pat92fr/SMDMod/ControlBoard/V2/BOM_SmartMotorDriver3A_2021-01-23.csv

ID | Name | Designator | Footprint | Quantity | Manufacturer Part | Manufacturer | Supplier | Supplier Part | JLCPCB SMD | LCSC Assembly
1 | 200 | R4,R8 | R0402 | 2 | 0402WGF2000TCE | UniOhm | LCSC | C25087
2 | 47R | R5 | R0402 | 1 | 0402WGF470JTCE | UniOhm | LCSC | C25118
3 | 100k | R6 | R0402 | 1 | 0402WGF1003TCE | UniOhm | LCSC | C25741
4 | 22k | R7 | R0402 | 1 | 0402WGF2202TCE | UniOhm | LCSC | C25768
5 | 2.2k | R3 | R0402 | 1 | 0402WGF2201TCE | UniOhm | LCSC | C25879
6 | 20k | R9 | R0402 | 1 | 0402WGF2002TCE | UniOhm | LCSC | C25765
7 | LED-0603_R | LED2,LED1 | LED0603_RED | 2 | 19-213/Y2C-CQ2R2L/3T(CY) | EVERLIGHT | LCSC | C72038
8 | STM32G431K8T6 | U1 | LQFP-32_L7.0-W7.0-P0.80-LS9.0-BL | 1 | STM32G431KBT6 | STMicroelectronics | LCSC | C529357
9 | DRV8876PWPR | U3 | HTSSOP-16_L5.0-W4.4-P0.65-LS6.4-BL-EP | 1 | DRV8876PWPR | Texas Instruments | LCSC | C575551 | Yes | Yes
10 | HDR-M-2.54_1x6 | J5 | HDR-M-2.54_1X6 | 1 |  |  | LCSC | C190819
11 | 100nF | C15,C16 | C0603 | 2 | CC0603KRX7R9BB104 | YAGEO | LCSC | C14663 | Yes | Yes
12 | HDR-M-2.54_1x1 | J3,J4,J12 | HDR-M-2.54_1X1 | 3 |  |  | LCSC | C81276
13 | 1.1K | R2 | R0402 | 1 | 0402WGF1101TCE | UniOhm | LCSC | C25860 | Yes | Yes
14 | 470uF | C6 | CAP-SMD_BD10.0-L10.3-W10.3-FD | 1 | RVT1V471M1010 | ROQANG | LCSC | C72519 |  | Yes
15 | TLV70433DBVT | U2 | TSOT-23-5_L2.9-W1.6-P0.95-LS2.8-BR | 1 | TLV70433DBVT | Texas Instruments | LCSC | C94776 | Yes
16 | 10uH | L1 | L0603 | 1 | LBMF1608T100K | TAIYO YUDEN | LCSC | C87216
17 | HDR-M-2.54_1x3 | J2 | HDR-M-2.54_1X3 | 1 |  |  | LCSC | C180248
18 | HDR-M-2.54_1x5 | J1 | HDR-M-2.54_1X5 | 1 |  |  | LCSC | C358687
19 | NC7SP125P5X | U5,U6 | SC-70-5_L2.1-W1.3-P0.65-LS2.1-BR | 2 | NC7SP125P5X | ON Semicon | LCSC | C184652 |  | Yes
20 | TEST-POINT3X5 | TP14,TP1,TP3 | PAD.03X.05 | 3
21 | 1uF | C1,C12 | C0402 | 2 | CL05A105KA5NQNC | SAMSUNG | LCSC | C52923
22 | 4.7uF | C2,C8 | C0402 | 2 | CL05A475MP5NRNC | SAMSUNG | LCSC | C23733
23 | 100nF | C3,C7,C9,C10,C5,C14 | C0402 | 6 | CL05B104KO5NNNC | SAMSUNG | LCSC | C1525
24 | 10nF | C11 | C0402 | 1 | CL05B103KB5NNNC | SAMSUNG | LCSC | C15195
25 | 0.1u | C18 | C0402 | 1 | CL05B104KO5NNNC | SAMSUNG | LCSC | C1525
26 | 22n | C19 | C0402 | 1 | 0402B223K500NT | FH | LCSC | C1532
