pat92fr/SMDMod/ControlBoard/V2/Schematic_SmartMotorDriver3A_2021-01-23.pdf

## Connecteur de puissance et mesure de tension

## Contr leur de puissance moteur et mesure de courant

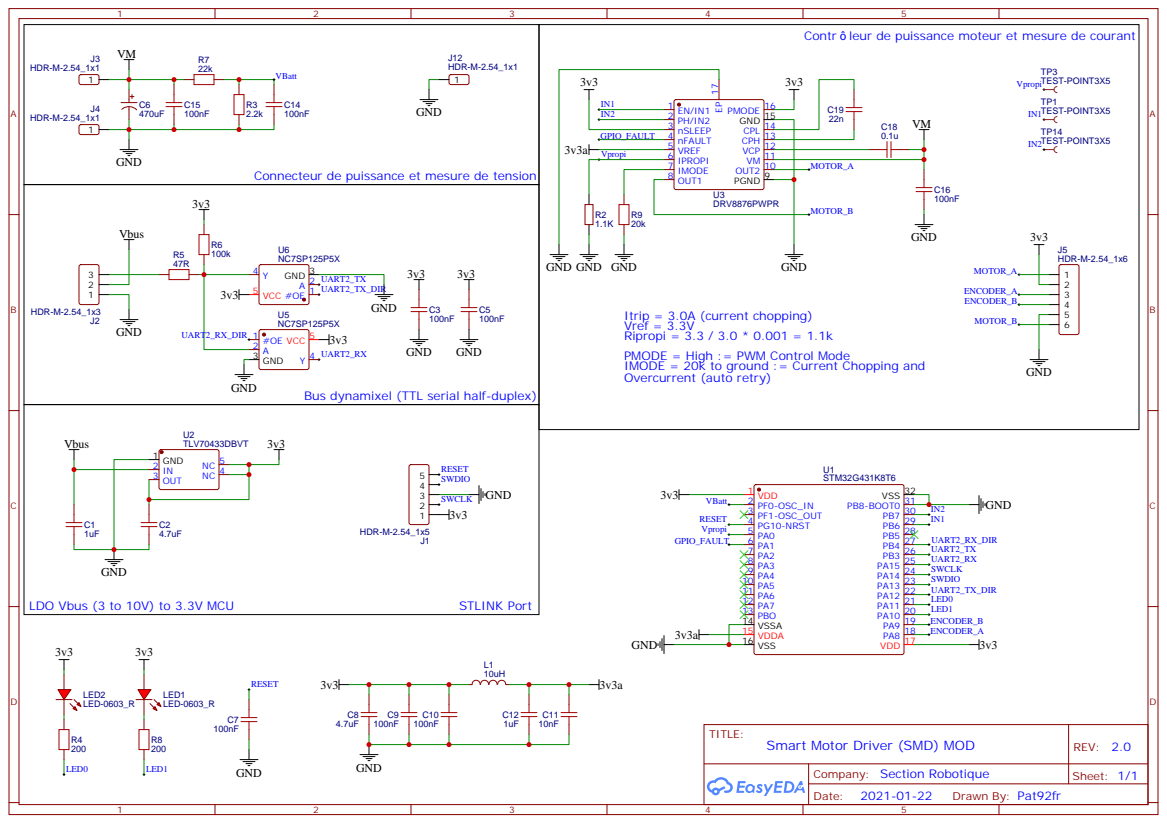
[picture p1: page 1]

OUT2 10 VM 11 VCP 12 CPH 13 CPL 14 GND 15 PMODE 16

Vref = 3.3V
Ripropi = 3.3 / 3.0 * 0.001 = 1.1k
PMODE = High := PWM Control Mode
IMODE = 20k to ground := Current Chopping and
Overcurrent (auto retry)

Bus dynamixel (TTL serial half-duplex)
