pat92fr/SMDMod/ControlBoard/V1/Schematic_SmartMotorDriver3A_2021-01-22.pdf

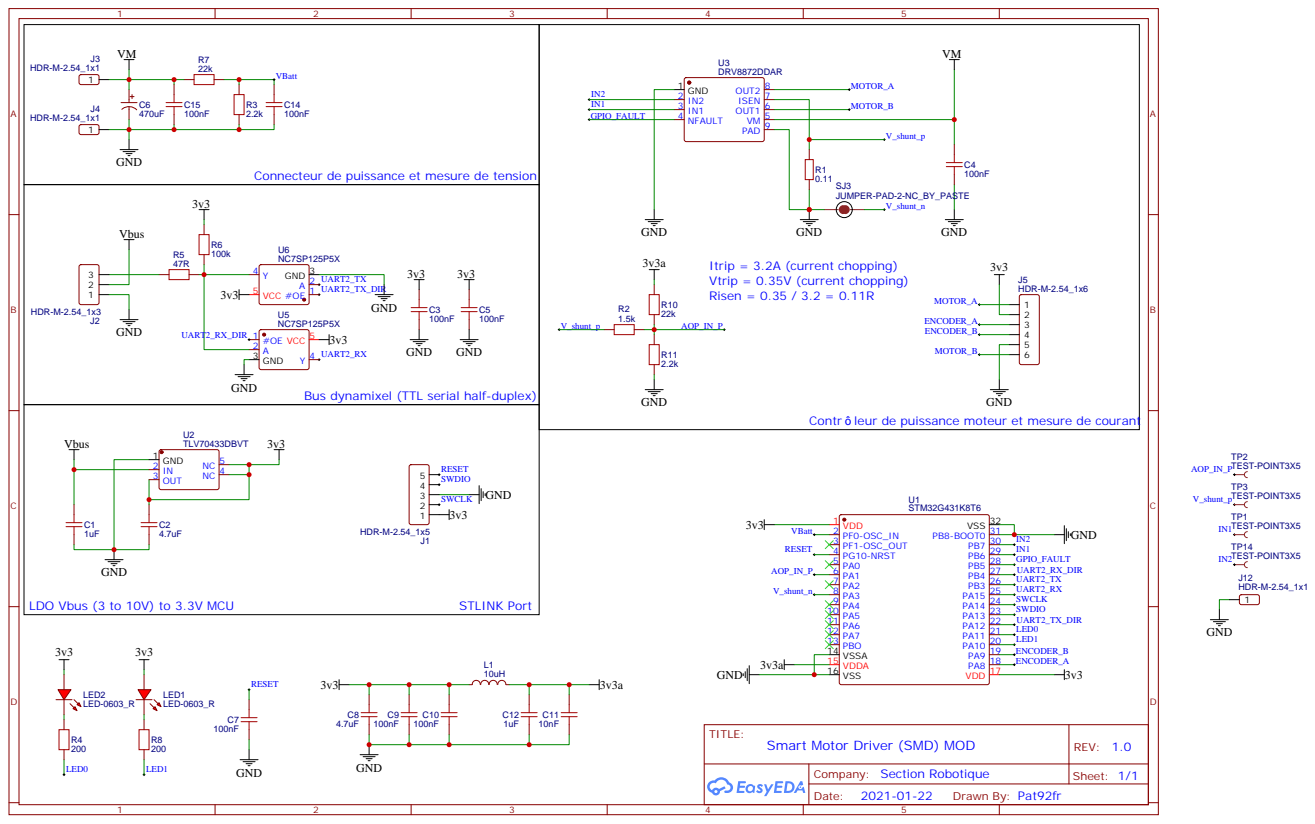
[picture p2: page 1]

Connecteur de puissance et mesure de tension

Bus dynamixel (TTL serial half-duplex)

Contr leur de puissance moteur et mesure de courant
