pat92fr/SMDMod/ControlFirmware/Core/Src/main.c

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
/* Includes ------------------------------------------------------------------*/
#include "main.h"

/* USER CODE BEGIN Includes */
#include "led.h"
#include "serial.h"
#include "eeprom.h"
#include "control_table.h"
#include "control_algo.h"
#include "protocol.h"
/* USER CODE END Includes */

ADC_HandleTypeDef hadc1;
DMA_HandleTypeDef hdma_adc1;

TIM_HandleTypeDef htim1;
TIM_HandleTypeDef htim4;
TIM_HandleTypeDef htim6;

UART_HandleTypeDef huart2;
DMA_HandleTypeDef hdma_usart2_rx;
DMA_HandleTypeDef hdma_usart2_tx;

/* USER CODE BEGIN PV */
HAL_Serial_Handler serial;
/* USER CODE END PV */

void SystemClock_Config(void);
static void MX_GPIO_Init(void);
static void MX_DMA_Init(void);
static void MX_ADC1_Init(void);
static void MX_TIM1_Init(void);
static void MX_TIM4_Init(void);
static void MX_USART2_UART_Init(void);
static void MX_TIM6_Init(void);
/**
  * @brief  The application entry point.
  * @retval int
  */
int main(void)
{
  /* MCU Configuration--------------------------------------------------------*/

  /* Reset of all peripherals, Initializes the Flash interface and the Systick. */
  HAL_Init();

  /* Configure the system clock */
  SystemClock_Config();

  /* Initialize all configured peripherals */
  MX_GPIO_Init();
  MX_DMA_Init();
  MX_ADC1_Init();
  MX_TIM1_Init();
  MX_TIM4_Init();
  MX_USART2_UART_Init();
  MX_TIM6_Init();
  /* USER CODE BEGIN 2 */
	HAL_Led_Init();
	HAL_Led_Blink(LED0,10,150);
	HAL_Led_Blink(LED1,10,150);
	HAL_Serial_Init_Half_Duplex(
		&huart2,
		&serial,
		UART2_TX_DIR_GPIO_Port,
		UART2_TX_DIR_Pin,
		GPIO_PIN_RESET,
		UART2_RX_DIR_GPIO_Port,
		UART2_RX_DIR_Pin,
		GPIO_PIN_RESET
	);
	if(eeprom_empty())
		factory_reset_eeprom_regs();
	load_eeprom_regs();
	reset_ram_regs();
	APP_Control_Init();
  /* USER CODE END 2 */

  /* Infinite loop */
  /* USER CODE BEGIN WHILE */
	uint32_t start_time = HAL_GetTick();
  while (1)
  {
    /* USER CODE END WHILE */

    /* USER CODE BEGIN 3 */
	  // Handle LED
	if(HAL_GetTick()>start_time+2000) // blink first 2 seconds
	{
		if(regs[REG_LED]==0)
		{
			HAL_Led_Reset(LED0);
		}
		else if(regs[REG_LED]==1)
		{
			HAL_Led_Set(LED0);
		}
	}
	HAL_Led_Process();

	// Handle communication
	while(HAL_Serial_Available(&serial))
	{
	  char c = HAL_Serial_GetChar(&serial);
	  packet_handler(c);
	}

	// regulation
	APP_Control_Process();
  }
  /* USER CODE END 3 */
}

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
