pat92fr/SMDMod/ControlFirmware/ControlFirmware.ioc

Mcu.UserName=STM32G431KBTx
PA0.Signal=ADC1_IN1
PA1.GPIO_Label=GPIO_FAULT
PA1.Signal=GPIO_Input
PA10.GPIO_Label=LED1
PA10.Signal=GPIO_Output
PA11.GPIO_Label=LED0
PA11.Signal=GPIO_Output
PA12.GPIO_Label=UART2_TX_DIR
PA12.Signal=GPIO_Output
PA13.Signal=SYS_JTMS-SWDIO
PA14.Signal=SYS_JTCK-SWCLK
PA15.Signal=USART2_RX
PA8.Signal=S_TIM1_CH1
PA9.Signal=S_TIM1_CH2
PB3.Signal=USART2_TX
PB4.GPIO_Label=UART2_RX_DIR
PB4.Signal=GPIO_Output
PB6.Signal=S_TIM4_CH1
PB7.Signal=S_TIM4_CH2
PF0-OSC_IN.Signal=ADC1_IN10
