pat92fr/SMDMod/ControlFirmware/Core/Inc/main.h

#define GPIO_FAULT_Pin GPIO_PIN_1
#define GPIO_FAULT_GPIO_Port GPIOA
#define LED1_Pin GPIO_PIN_10
#define LED1_GPIO_Port GPIOA
#define LED0_Pin GPIO_PIN_11
#define LED0_GPIO_Port GPIOA
#define UART2_TX_DIR_Pin GPIO_PIN_12
#define UART2_TX_DIR_GPIO_Port GPIOA
#define UART2_RX_DIR_Pin GPIO_PIN_4
#define UART2_RX_DIR_GPIO_Port GPIOB
