pat92fr/SMDMod/ControlFirmware/Core/Inc/led.h

/*
 * led.h
 *
 *  Created on: 25 d�c. 2015
 *      Author: Patrick
 */

#ifndef APPLICATION_USER_HAL_LED_H_
#define APPLICATION_USER_HAL_LED_H_


/* Includes ------------------------------------------------------------------*/
#include "stm32g4xx_hal.h"
#include "main.h"

#ifdef __cplusplus
extern "C" {
#endif

/* HAL settings ------------------------------------------------------------------*/

enum LED_ID
{
	LED0 = 0,
	LED1 = 1,
	LED_COUNT
};

static uint16_t const hal_led_id_to_pin[LED_COUNT] = {
		LED0_Pin,
		LED1_Pin
};

static GPIO_TypeDef * const hal_led_id_to_port[LED_COUNT] = {
		LED0_GPIO_Port,
		LED1_GPIO_Port
};

/* HAL Public Data ------------------------------------------------------------------*/

enum LED_STATE
{
    LED_OFF = 0,
    LED_ON = 1
};

/* HAL Functions ------------------------------------------------------------------*/

void HAL_Led_Init(void);
void HAL_Led_Process(void);

void HAL_Led_Set(int id);
void HAL_Led_Reset(int id);
void HAL_Led_Toggle(int id);

int HAL_Led_Get(int id);

void HAL_Led_Blink(int id, int times, int period_ms); // times = 0 ==> non stop blinking

#ifdef __cplusplus
}
#endif

#endif /* APPLICATION_USER_HAL_LED_H_ */
