pat92fr/SMDMod/SMDFireTest/include/sm_protocol.h

// MyServoProtocol is using Serial1 on MEGA
// MyServoProtocol is using Serial2 on M5Stack FIRE (through port C)

// GROVE C port is TX:GPIO17 RX:GPIO16 not usable on fire !
#include <M5Stack.h>
#define GPIO_PIN26 26
#define GPIO_PIN36 36

// REGISTER ADDRESS ///////////////////////////////////////////////////////////

// EEPROM
#define REG_MODEL_NUMBER_L 			0x00
#define REG_MODEL_NUMBER_H 			0x01
#define REG_VERSION		 			0x02
#define REG_ID             			0x03
#define REG_BAUD_RATE      			0x04
#define REG_RETURN_DELAY   			0x05

#define REG_RESERVED_EEPROM_1		0x10 // unused
#define REG_RESERVED_EEPROM_2		0x11 // unused
#define REG_RESERVED_EEPROM_3		0x12 // unused
#define REG_RESERVED_EEPROM_4		0x13 // unused
#define REG_MAX_VELOCITY_DPS_L		0x14
#define REG_MAX_VELOCITY_DPS_H		0x15
#define REG_MAX_ACCELERATION_DPSS_L	0x16
#define REG_MAX_ACCELERATION_DPSS_H	0x17
#define REG_MAX_CURRENT_MA_L		0x18
#define REG_MAX_CURRENT_MA_H		0x19
#define REG_MAX_PWM_100_L			0x1A
#define REG_MAX_PWM_100_H			0x1B
#define REG_TEMPERATURE_LIMIT		0x1C // no sensor
#define REG_LOW_VOLTAGE_LIMIT		0x1D
#define REG_HIGH_VOLTAGE_LIMIT		0x1E

#define REG_MOVING_THRESHOLD_DPS	0x1F
#define REG_STATUS_RETURN_LVL		0x20
#define REG_ALARM_LED				0x21
#define REG_ALARM_SHUTDOWN			0x22

#define REG_CPR_L					0x23
#define REG_CPR_H					0x24
#define REG_REDUCER_L				0x25
#define REG_REDUCER_H				0x26
#define REG_RESERVED_EEPROM_5		0x27 // unused
#define REG_INV_ROTATION_MOTOR		0x28
#define REG_INV_ROTATION_SENSOR 	0x29

#define REG_PID_VELOCITY_KP_L		0x2A
#define REG_PID_VELOCITY_KP_H		0x2B
#define REG_PID_VELOCITY_KI_L		0x2C
#define REG_PID_VELOCITY_KI_H		0x2D
#define REG_PID_VELOCITY_KD_L		0x2E
#define REG_PID_VELOCITY_KD_H		0x2F
#define REG_PID_VELOCITY_KFF_L		0x30
#define REG_PID_VELOCITY_KFF_H		0x31
#define REG_PID_ACCELERATION_KFF_L	0x32
#define REG_PID_ACCELERATION_KFF_H	0x33
#define REG_PID_CURRENT_KP_L		0x34
#define REG_PID_CURRENT_KP_H		0x35
#define REG_PID_CURRENT_KI_L		0x36
#define REG_PID_CURRENT_KI_H		0x37
#define REG_PID_CURRENT_KFF_L		0x38
#define REG_PID_CURRENT_KFF_H		0x39

#define REG_CAL_CURRENT_SENSE_A_L	0x3A
#define REG_CAL_CURRENT_SENSE_A_H	0x3B
#define REG_CAL_VOLTAGE_SENSE_L		0x3C
#define REG_CAL_VOLTAGE_SENSE_H		0x3D

// RAM
#define REG_TORQUE_ENABLE  					0x40
#define REG_LED			  					0x41
#define REG_CONTROL_MODE					0x42
#define REG_GOAL_ACCELERATION_DPSS_L		0x43
#define REG_GOAL_ACCELERATION_DPSS_H		0x44
#define REG_GOAL_VELOCITY_DPS_L				0x45
#define REG_GOAL_VELOCITY_DPS_H				0x46
#define REG_GOAL_CURRENT_MA_L				0x47
#define REG_GOAL_CURRENT_MA_H				0x48
#define REG_GOAL_PWM_100_L					0x49
#define REG_GOAL_PWM_100_H					0x4A
#define REG_RESERVED_RAM_1					0x4B // unused
#define REG_RESERVED_RAM_2					0x4C // unused
#define REG_PRESENT_ACCELERATION_DPSS_L		0x4D
#define REG_PRESENT_ACCELERATION_DPSS_H		0x4E
#define REG_PRESENT_VELOCITY_DPS_L			0x4F
#define REG_PRESENT_VELOCITY_DPS_H			0x50
#define REG_PRESENT_CURRENT_MA_L			0x51
#define REG_PRESENT_CURRENT_MA_H			0x52
#define REG_PRESENT_VOLTAGE					0x53
#define REG_PRESENT_TEMPERATURE 			0x54 // no sensor
#define REG_MOVING			 				0x55
// DEBUG RAM
#define REG_SETPOINT_ACCELERATION_DPSS_L	0x56
#define REG_SETPOINT_ACCELERATION_DPSS_H	0x57
#define REG_SETPOINT_VELOCITY_DPS_L			0x58
#define REG_SETPOINT_VELOCITY_DPS_H			0x59
#define REG_SETPOINT_CURRENT_MA_L			0x5A
#define REG_SETPOINT_CURRENT_MA_H			0x5B
#define REG_SETPOINT_PWM_100_L				0x5C
#define REG_SETPOINT_PWM_100_H				0x5D
#define REG_MOTOR_CURRENT_INPUT_ADC_L 		0x5E
#define REG_MOTOR_CURRENT_INPUT_ADC_H		0x5F
#define REG_DEBUG_RAM_RESERVED_1   			0x60 // unused
#define REG_DEBUG_RAM_RESERVED_2 			0x61 // unused
#define REG_ENCODER_ABSOLUTE_L				0x62
#define REG_ENCODER_ABSOLUTE_H				0x63
#define REG_VOLTAGE_INPUT_ADC_L				0x64
#define REG_VOLTAGE_INPUT_ADC_H				0x65
// SW & HW ERROR
#define REG_PROTOCOL_CRC_FAIL 				0x80
#define REG_HARDWARE_ERROR_STATUS 			0x81
// End
#define REG_MAX             				0x82

// REGISTER CONTROL MODE VALUES //////////////////////////////////////////////////////

#define REG_CONTROL_MODE_OFF 0
#define REG_CONTROL_MODE_ACCELERATION_PROFIL_VELOCITY_TORQUE 1
#define REG_CONTROL_MODE_VELOCITY_TORQUE 2
#define REG_CONTROL_MODE_CURRENT 3
#define REG_CONTROL_MODE_PWM 4


// Buffers
#define TX_BUFFER_SIZE 256
#define RX_BUFFER_SIZE 256

// Packet field position
#define PKT_HEADER0             0
#define PKT_HEADER1             1
#define PKT_HEADER2             2
#define PKT_RESERVED            3
#define PKT_ID                  4
#define PKT_LENGTH_L            5
#define PKT_LENGTH_H            6
#define PKT_INSTRUCTION         7
#define PKT_ERROR               8
#define PKT_PARAMETER0          8
#define PKT_PARAMETER1          9
#define PKT_PARAMETER2          10
#define PKT_PARAMETER3          11
#define PKT_PARAMETER4          12

#define INSTR_PING            0x01
#define INSTR_READ            0x02
#define INSTR_WRITE           0x03
#define INSTR_FACTORY_RESET   0x06
#define INSTR_REBOOT          0x08
#define INSTR_STATUS          0x55
#define INSTR_SYNC_READ       0x82
#define INSTR_SYNC_WRITE      0x83

#define ERROR_NONE                0x00
#define ERROR_RESULT_FAIL         0x01
#define ERROR_INSTRUCTION_ERROR   0x02
#define ERROR_CRC_ERROR           0x03
#define ERROR_DATA_RANGE_ERROR    0x04
#define ERROR_DATA_LENGTH_ERROR   0x05
#define ERROR_DATA_LIMIT_ERROR    0x06
#define ERROR_ACCESS_ERROR        0x07

// binary tool macro
#define LOW_BYTE(x)     ((unsigned char)((x)&0xFF))
#define HIGH_BYTE(x)    ((unsigned char)(((x)>>8)&0xFF))
#define MAKE_SHORT(l,h) (((uint16_t)((h)&0xFF)<<8) | (uint16_t)((l)&0xFF))
#define SIGN(x)         (((x)&0x8000)?((x)-0x10000):(x))


class sm_protocol
{
  
public:  
  sm_protocol(uint32_t baud):
    verbose(0),
    rx_packet_position(0),
    rx_packet_payload_length(0),
    tx_packet_length(0),
    rx_packet_id(0),
    rx_packet_instruction(0),
    rx_packet_error(0),
    rx_packet_crc(0),
    rx_timeout_us(10000),
    MySerial(2)
    {
        // MEGA 16MHz:
        //  baud = 115200 OK 1.4ms reply
        //  baud = 250000 OK 0.7ms reply
        //  baud = 500000 OK 440us reply
        //  baud = 1000000 OK 430us reply
        // M5Stack:
        //  baud = 500000 OK
        //  baud = 1000000 OK
        MySerial.begin(baud, SERIAL_8N1,GPIO_PIN36,GPIO_PIN26);
    } // 10ms
  
    int verbose;

    struct sync_byte_data
  {
    uint8_t id;
    uint8_t length;
    uint8_t data[16];
    // helpers
    sync_byte_data() : id(0), length(0) {}
    sync_byte_data(uint8_t const & i) : id(i), length(0) {}
    void add_param_u8(uint8_t const & param) { data[length++]=param;}
    void add_param_f(float const & param) { data[length++]=(uint8_t)(param);}
  };

  struct sync_word_data
  {
    uint8_t id;
    uint8_t length;
    uint16_t wdata[8];
    // helpers
    sync_word_data() : id(0), length(0) {}
    sync_word_data(uint8_t const & i) : id(i), length(0) {}
    void add_param_u16(uint16_t const & param) { wdata[length++]=param;}
    void add_param_f(float const & param) { wdata[length++]=(uint16_t)(param);}
  } ;


    // Low lew commands
  int pingCommand(uint8_t id, uint16_t * model_number, uint8_t * firmware_version);
  int readByteCommand(uint8_t id, uint16_t address, uint16_t length, uint8_t * data);
  int readWordCommand(uint8_t id, uint16_t address, uint16_t length, uint16_t * data);
  int writeByteCommand(uint8_t id, uint16_t address, uint16_t length, uint8_t const * data);
  int writeWordCommand(uint8_t id, uint16_t address, uint16_t length, uint16_t const * data);  
  void syncWriteByteCommand(uint16_t address, uint8_t number_of_ids, sync_byte_data const *data);
  int syncWriteWordCommand(uint16_t address, uint8_t number_of_ids, sync_word_data const *data);
  int factoryResetCommand(uint8_t id);
  int rebootCommand(uint8_t id);

    // Utility SMS commands
    /*
  void syncWriteByteCommand(uint16_t address, uint8_t number_of_ids, sync_byte_data const * data);
  int syncWriteWordCommand(uint16_t address, uint8_t number_of_ids, sync_word_data const * data);
  int enableTorque(uint8_t id);
  int disableTorque(uint8_t id);
  int enableLed(uint8_t id);  
  int disableLed(uint8_t id);
  int setMode(uint8_t id, uint8_t mode);
  int setPosition(uint8_t id, float angle_deg);
  int setVelocityLimit(uint8_t id, float velocity_dps);
  int setPositionVelocity(uint8_t id, float angle_deg, float velocity_dps);
  int setCurrentLimit(uint8_t id, uint16_t current_mA);
  int setPWMLimit(uint8_t id, uint8_t pwm_pc);
  int setPositionVelocityCurrentPWM(uint8_t id, float angle_deg, float velocity_dps, uint16_t current_mA, uint8_t pwm_pc);
  float getPosition(uint8_t id, int * error);
  float getVelocity(uint8_t id, int * error);
  float getCurrent(uint8_t id, int * error);

  */
    
private:

  uint8_t tx_packet_buffer[TX_BUFFER_SIZE];
  uint8_t rx_packet_buffer[RX_BUFFER_SIZE];
  
  uint32_t rx_packet_position;
  uint16_t rx_packet_payload_length;
  uint32_t tx_packet_length;

  uint8_t rx_packet_id;
  uint8_t rx_packet_instruction;
  uint8_t rx_packet_error;
  uint16_t rx_packet_crc;  
  unsigned long rx_timeout_us;
  HardwareSerial MySerial;

  uint16_t updateCRC(uint16_t crc_accum, uint8_t *data_blk_ptr, uint16_t data_blk_size);  
  void serialFlush();
  void completePacket(uint8_t id, uint16_t payload_length); // length from instruction byte to last parameter byte
  int receiveStatusPacket(uint8_t id, unsigned long timeout_us);
  bool decodePacket(int b);
  

      
};
