pat92fr/SMDMod/(commit log)

2021-02-04 PWM control OK
2021-02-04 current control OK
2021-02-04 up encoder ok
2021-02-04 minor correction for include
    [led.c]
2021-02-04 velocity torque control OK
2021-02-05 control table update and current offset suppress
2021-02-05 fix control algo and improve PID settings for D25mm Gui python update baud rate fix
    [SMDUtility.py, control_algo.c, control_table.c, control_table.h, eeprom_frame.py, main.c, ram_frame.py, trace_frame.py]
2021-02-07 PWM test + ROS connection
2021-04-09 Correction bug lecture registre de capteur
    [control_algo.c]
